crazy-cat-crypto/3d-mapping-explorer-robot/JOURNAL.md

## Day 1
### Materials gathered:

Arduino Uno

Breadboard

2× L298N Motor Driver

2× DC Motors with wheels

Hot glue gun

### Materials to buy

1. ultrasonic sensor(HC-SR04) - Rs. 160
   https://www.giganepal.com/product/ultrasonic-sensor-hc-sr04/

2. wifi module(NodeMCU ESP8266) - Rs. 750
   https://www.daraz.com.np/tag/nodemcu-esp8266/

3. 2× servo motors(TowerPro SG 90 Micro Servo) - Rs. 270 each
   https://www.daraz.com.np/products/towerpro-sg-90-micro-servo-motor-i111549.html

4. 1 pack Hot glue stick - Rs. 125

5. 2× 18650 battery (3000 mAh) - Rs. 200 each
   https://ghumtipasal.com.np (search 18650 3000mah)

6. 2× Single 18650 holder (battery holder) - Rs. 69 each 
   https://www.daraz.com.np/products/single-18650-battery-holder-case-sn110-i129863643

7. TP4056 Type-C (battery charger) - Rs. 94
   https://www.daraz.com.np/products/tp4056-1s-li-ion-lithium-battery-charging-module-micro-b-usb-bms-i104206673.html

8. LM2596 (voltage converter) - Rs. 179
   https://www.daraz.com.np/products/lm2596-dc-dc-buck-converter-step-down-power-module1-pcs-i129863237.html

9. 1 set Jumper wires (40pcs mixed) - Rs. 240
   https://www.giganepal.com/categories/electronics-components/jumper-wires/

10. Simple rocker switch - Rs. 50
    https://www.daraz.com.np/tag/3-pin-rocker-switch/

Total Cost: Rs. 2,876 

## Day 2
### Materials bought:
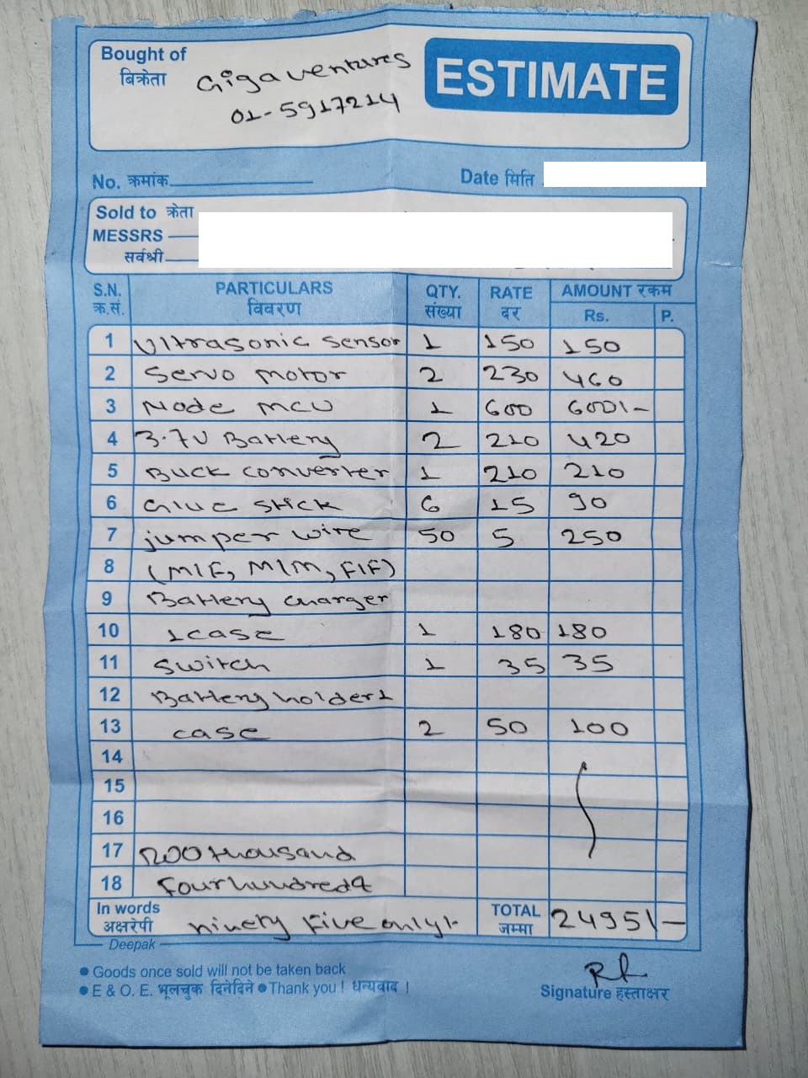
[picture p2: images/bill1.jpeg]
bill of parts bought

we realized arduino was not needed.

coded flask server such that it accepts json and converts it to csv

## Materials to buy/manage :
Servo brackets

base for robot

soldering gun with iron

wheels encoders

resistors ( 1k ohm, 2k ohm)

normal wires

Scissors 

Screw driver

## Day 3
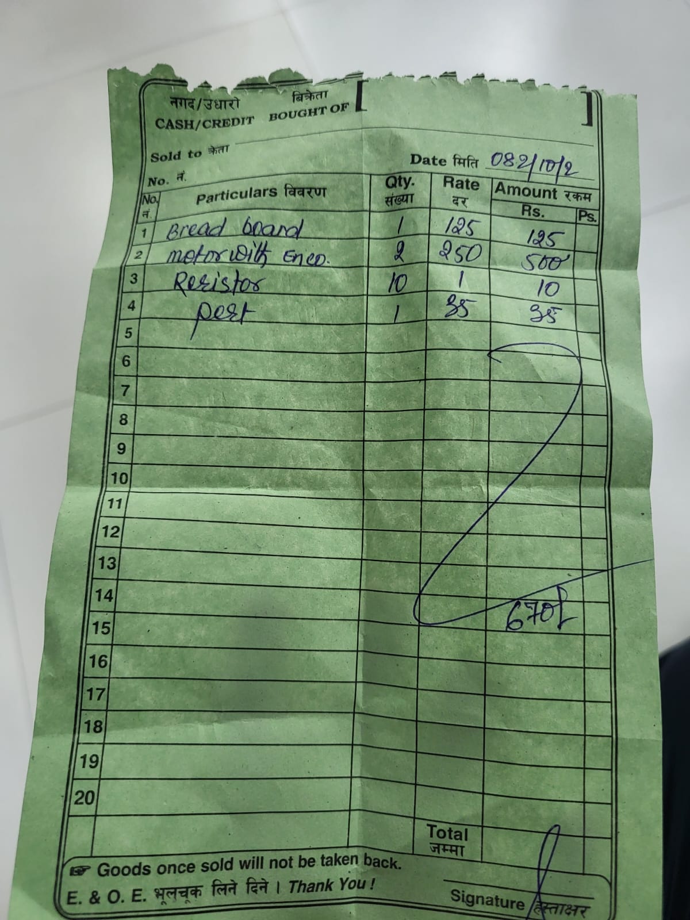
[picture p3: images/bill2.jpeg]
bill2 of materials bought

we realized that before starting a project you should consult with a expert then only buy parts.
we had to buy two new motor with encoders.

## Day 4
we joined some parts for robot base. We cut the spinning rod of new motor such that it could fit in our old motor gear.

## Day 5
joined wheels and made a little progress on base

went searching for wires to connect to encoders and servo brackets but could not find it.

## Day 6 
joined wheels with breadboard then realized we needed a caster weel, then i mistakenly broke the setup that we did in a day.

## Day 7
decided to solder wires as we couldnot find encoder wires

Bought all the remaining parts, fixed power supply.
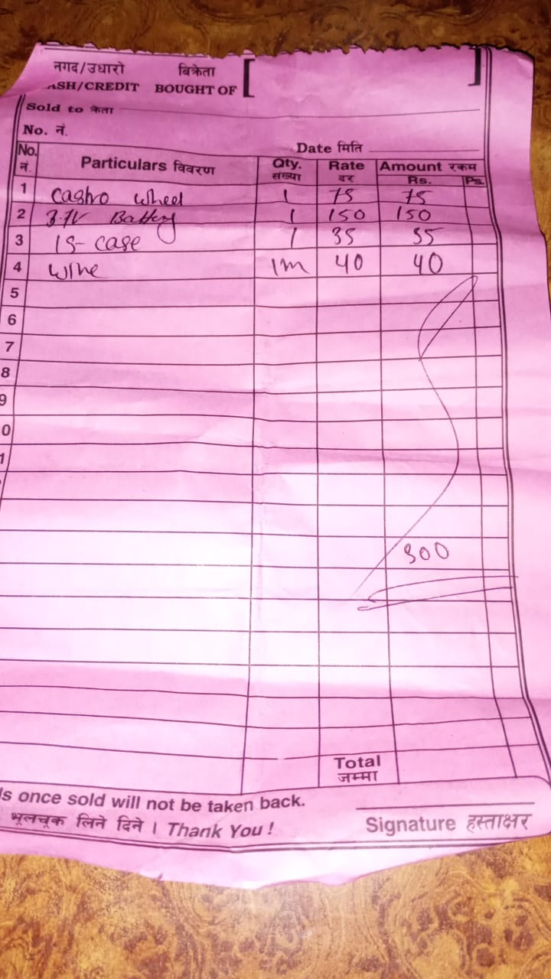
[picture p4: images/bill3.jpeg]
bill3 of materials bought

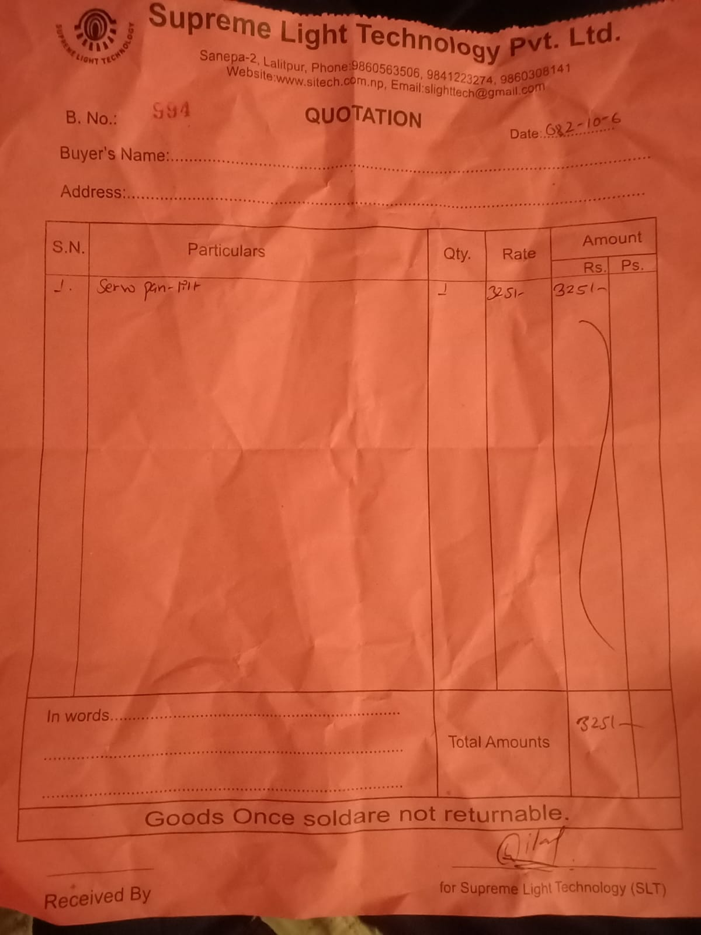
[picture p5: images/bill4.jpeg]
bill4 of materials bought


## Day 8
we had made a blunder by using thin wires to pass 12V with high current, so we had to remake our entire circuit. 

## Day 9
A little progress, we joined the circuit added motor driver and buck converter and made a pan and tilt servo.

## Day 10
Realized we needed capacitors
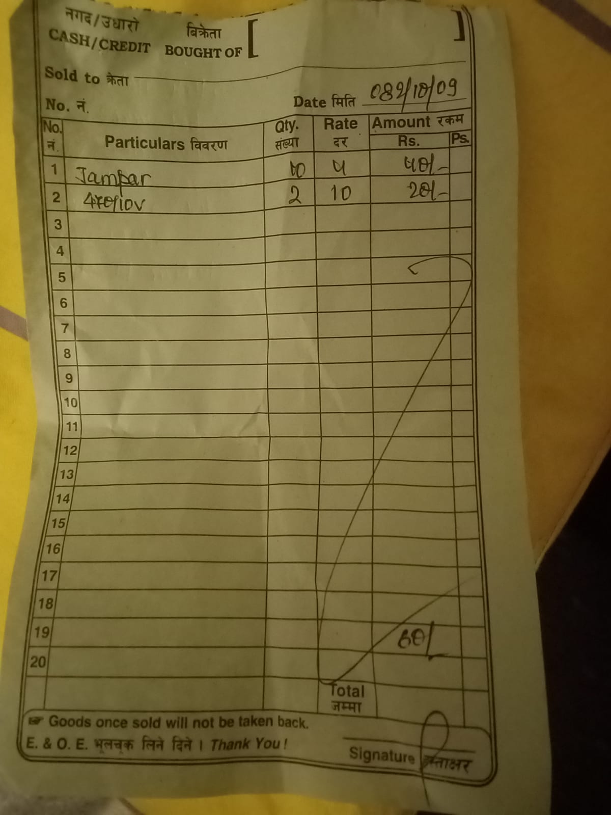
[picture p6: images/bill5.jpeg]
bill5 of materials bought

and we hotglued some parts

## Day 11
we soldered some parts and made plan for wheels

## Day 12
we broke a servo motor by oerspinning it so we had to buy a new one.

also we gave the motor with encoder to unexperienced techinican, so we has to again give it to a new technician.
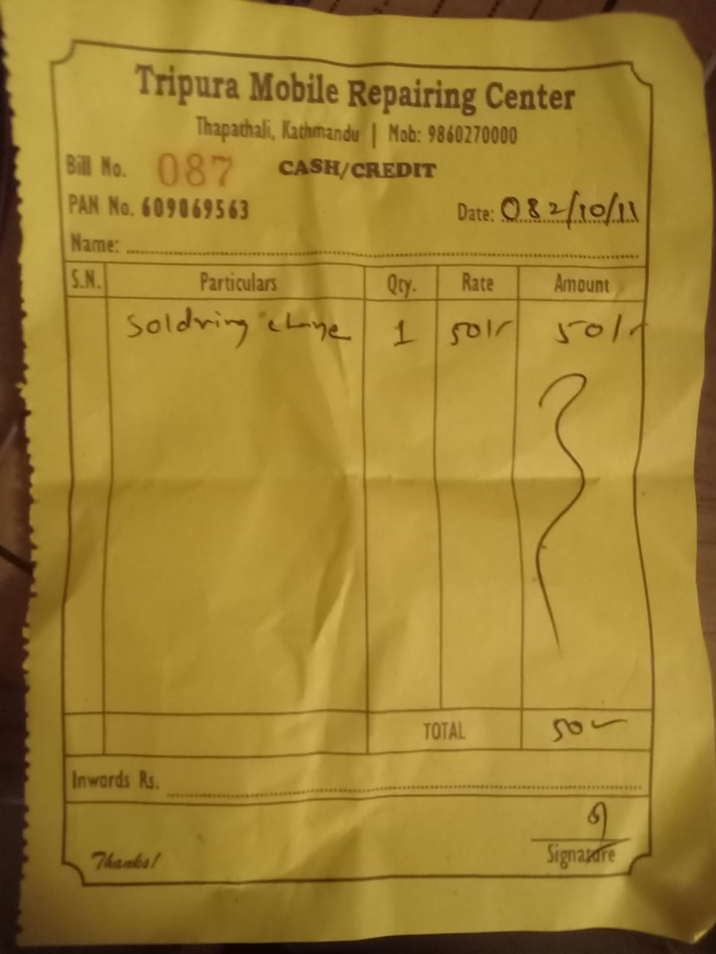
[picture p7: images/bill6.jpeg]
bill6 of materials bought

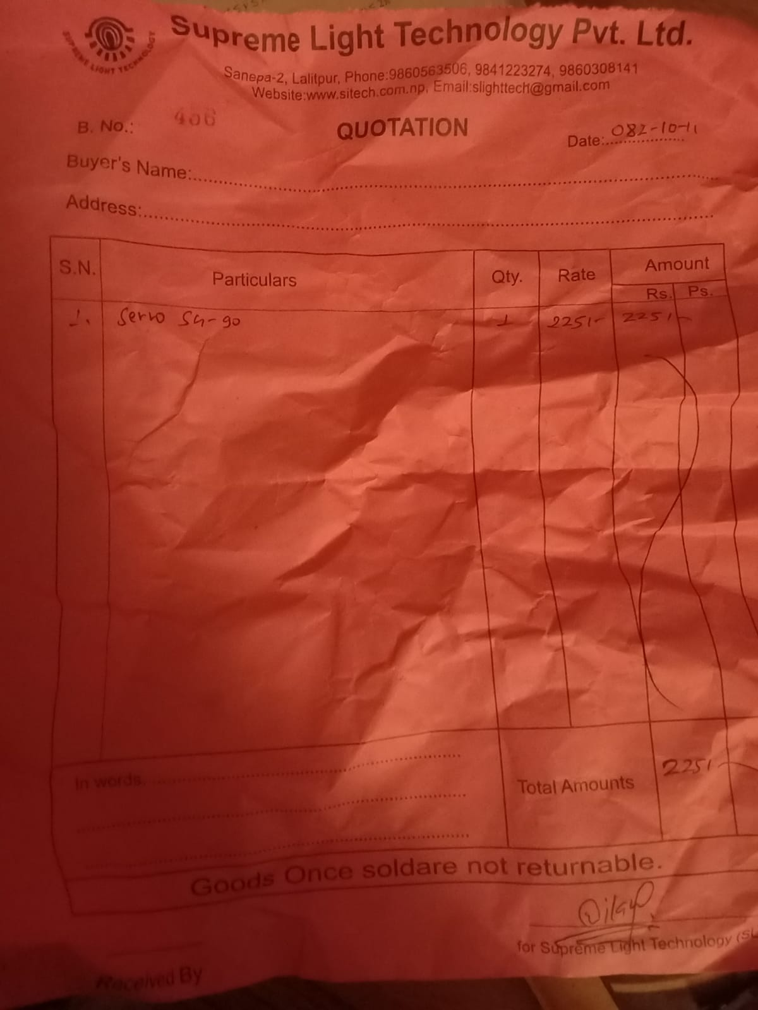
[picture p8: images/bill7.jpeg]
bill7 of materials bought


## Day 13
screwed and joined and soldered some parts

## Day 14
Finally attached servo motors and screwed some wires, made a clear roadmap to program.

## Day 15
joined the wheels with hotgluegun but they were not striaght.

## Day 16/17
coded occupancy grind and frontier algorithm

## Day 18
the soldering on the motor encoders had been broken, we couldnot solder it as pins were too small, also our robot wouldnot move straight, one was faster another slower. neither could it turn back, it would collapse.

## Day 19
the robot was still not moving straight and we cncluded the gears had problem.

## Day 20
we bought gears

## Day 21
we changed gears but still it was not moving striaght so even we changed the design of the structure

## Day 22
We soldered a lot of wires which where deattached because we didnot carefully handed the robot .we went to buy wheels but the shop has already been closed

## Day 23
still the robot was not moving staright so we replaced our thin wheels with thick ones; which we again had to goto buy

## Day 24
our motor with encoders somehow is sorted, two pins are connected to each other, not one but both. maybe the technician that soldered the wires had applied silicon so the soldering will be strong? So, we had no other option than to use PWN prediction as we didnot had wheels encoders.  
Also I have no real motivation to continue the journal as now the only remaining part is coding and we have to submit the project in 3 days.

## Day 25
