crazy-cat-crypto/3d-mapping-explorer-robot/config.py

# config.py

GRID_RESOLUTION = 0.05      # meters per cell
GRID_SIZE = 400             # 20m x 20m
MAX_RANGE = 4.0             # HC-SR04 max reliable range (m)

FRONTIER_CLUSTER_RADIUS = 3
SERIAL_PORT = "COM6"
BAUDRATE = 115200

ARDUINO_COMMAND_RATE = 10   # Hz
