crazy-cat-crypto/3d-mapping-explorer-robot/(commit log)

2025-12-25 add initial test script to print hello
2025-12-27 Remove empty Arduino sketch files and add new empty sketches for main, master, and test
2026-01-09 Add Day 1 journal entry with materials and costs
    Documented materials gathered and items to purchase for the project, including costs and links.
2026-01-15 Add additional materials and wiring details to JOURNAL.md; update app.py with network configuration comments
2026-01-16 Refactor project structure by adding communication, config, motors, navigation, and sensors modules; remove obsolete robot_data.csv file and clean up main.ino
2026-01-17 Add initial robot data CSV files
    - Created a new robot_data.csv file to store time and distance data.
    - Added an empty robot_data.csv file in the old_robot_data directory for historical reference.
    [robot_data.csv]
2026-01-20 Update JOURNAL.md with progress notes for Days 3 to 8 and add new images of materials bought
2026-01-23 Update JOURNAL.md with progress notes for Days 8 to 10, including circuit modifications and new components added
2026-01-24 Update robot data handling to include multiple object coordinates and movement data
    [robot_data.csv]
2026-01-28 Revise algorithms and data flow in Simple_Explanation.md
    Updated algorithms section to include sensor readings and improved clarity on data flow and processing steps.
2026-01-30 Update robot_data.csv structure to match new data format
    [robot_data.csv]
2026-02-02 Refactor app.py to use SocketIO for data handling and update CSV structure; add new journal entries in JOURNAL.md
2026-02-04 Add KDTree loop detection, theta in SLAM, and graph through matplotlib
    [robot_data_optimized.csv]
2026-02-06 Update JOURNAL.md with progress on gear changes and robot movement issues; modify implementation links in Simple_Explanation.md
2026-02-06 Update Simple_Explanation.md to clarify odometry measurement method using PWM and voltage compensation
2026-02-07 Add requirements file for NodeMCU compatibility and Arduino JSON
2026-02-07 Implement 3D mapping with pyplot
    [robot_data_optimized.csv]
2026-02-07 Remove testing data
    [robot_data_optimized.csv]
2026-02-07 Account for sensor height
2026-02-07 Implement real-time update in SLAM
    [robot_data.csv, robot_data_optimized.csv]
2026-02-08 Refactor odometry explanation in Simple_Explanation.md and update app.py to streamline data handling and remove unused socket functionality
2026-02-08 Update servo attachment parameters and enhance robot data logging format
    [robot_data.csv]
2026-02-08 Update WiFi server address and enhance scanning logic in main.ino; modify target initialization and threading in app.py
2026-02-09 Add 3D mesh
    [robot_data.csv, robot_data_optimized.csv]
2026-02-09 Update robot_data.csv with new entries and modify data loading in frontier_exploration function
    [robot_data.csv]
2026-02-09 ss s
    [robot_data_optimized.csv]
2026-02-09 Refactor robot data handling to use random target coordinates and update CSV data logging
    [robot_data.csv]
2026-02-09 Refactor code structure for improved readability and maintainability
    [robot_data.csv]
2026-02-09 Add new robot data entries for enhanced tracking and analysis
    [robot_data.csv]
2026-02-09 Add new robot data entries for improved tracking and analysis
    [robot_data.csv]
2026-02-10 Implement feature X to enhance user experience and fix bug Y in module Z
    [robot_data.csv]
2026-02-10 Update README with project details and known issues
    Added project context and outlined current code issues.
